exie1122/micro-quad-SLAM/drone photo.png

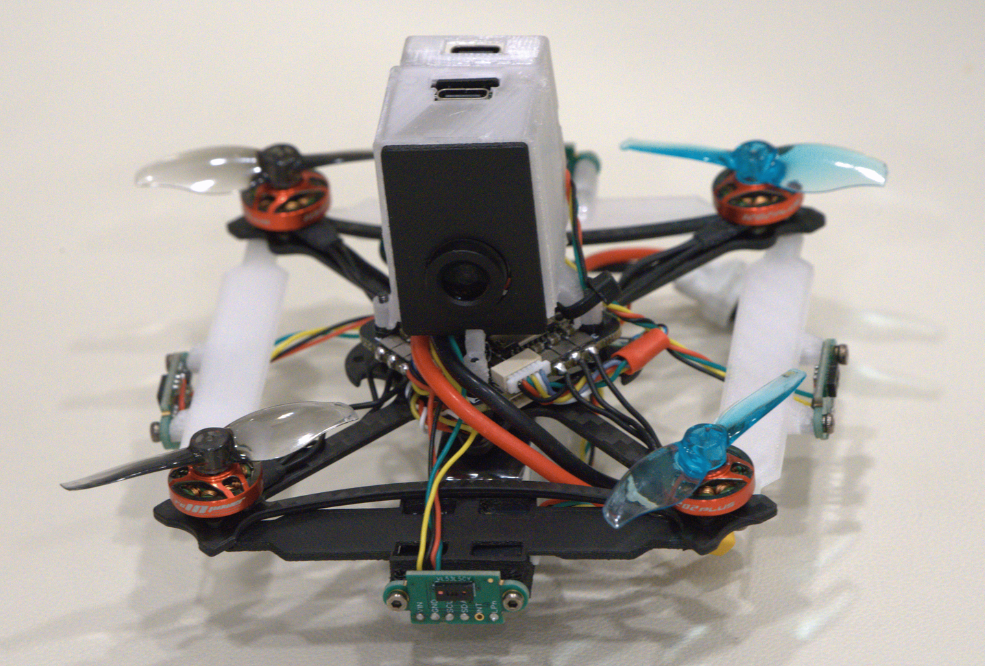
drone photo.png
