exie1122/micro-quad-SLAM/mapped_environment_2.png

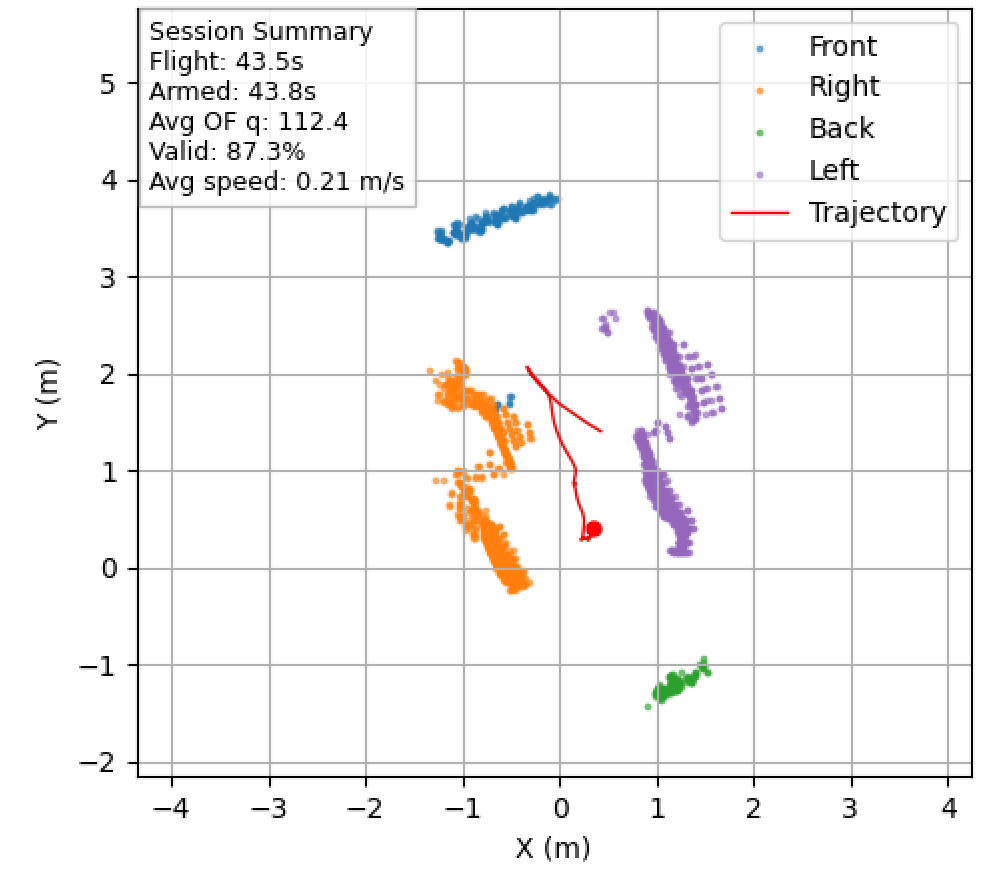
mapped_environment_2.png
