exie1122/micro-quad-SLAM/(commit log)

2026-01-23 Critical behaviour fixes. Previous version did not throttle up on TAKEOFF.
    [uav_local_nav.c]
2026-01-29 Add drift/flip fix for XY stability in hover control
    Implement drift and flip fix by ensuring XY stability before allowing position hold and exploration translation. Introduce new functions to check XY stability and modify hover hold behavior accordingly.
    [uav_local_nav.c]
2026-01-31 Change PRINT_HZ from 5 to 2 and adjust disarm timing
    Lowered PRINT_HZ, adjusted disarm timing and logic for safety. Most aspects of this commit were just a step back to my backup, since the new version flips quite often.
    [uav_local_nav.c]
2026-01-31 Adjust disarm command timing and conditions
    Reduce the minimum time between disarm commands from 50ms to 10ms. Remove altitude checks for forced disarm.
    Note: In ardupilot, also drastically decreased the roll and pitch P and I rates by around 60%, since there were audible and visible oscillations around the yaw axis.
    [uav_local_nav.c]
2026-03-10 Enhance hover phase management and safety checks
    Refactor hover control logic and improve stability checks. March 9th, 2026. 30 days until the science fair.
    [clean_uav_fc_tof_nav.c]
2026-03-12 Add manual UAV flight controller with logging
    This file implements a manual UAV flight controller for logging ToF data and MAVLink messages. It includes UART configuration, logging mechanisms, and various MAVLink message handlers for sensor data processing.
2026-03-15 Implement ToF scan log visualization in plot_scan.py
    Add a script to parse and visualize ToF scan logs with configurable parameters and filters.
    Includes:
    - Yaw estimation through Manhattan logic
    - 3D ray shifts for pitch/roll
    - Frame/accum. switches
    - Quality % filtering
2026-03-15 Adjust sensor position calculations with scaling
2026-03-19 Enhance plot_scan.py with new row mode and filter options
    Refactor plot_scan.py to improve functionality and add new features.
2026-03-25 Refine hover and takeoff logic with EKF integration
    Updated various constants and logic for hover and takeoff behavior, including adjustments to XY lock dwell time, velocity limits, and ceiling descent parameters. Added EKF status report handling and refined logging for altitude and EKF variance.
    Solved Problems:
    Auto land
    Yaw "twitch" without drift
    Overelaxed poshold conditions
    [clean_uav_fc_tof_nav.c]
2026-03-31 Refactor sendCmd and update PEER_MAC address
    Updated PEER_MAC address and modified sendCmd function to support sending commands multiple times with a delay. Adjusted button behavior for ARM and DISARM commands.
2026-03-31 Refactor sensor setup and enhance logging
    Refactor sensor initialization and update print statements for clarity.
2026-04-03 Add Flight Session Viewer GUI for UAV log files
    This script provides a GUI for parsing UAV log files, allowing users to browse arm sessions, copy data to clipboard, or export it.
2026-04-03 Refine hover and takeoff parameters for stability
    Adjust hover and takeoff parameters for improved stability and performance.
    [clean_uav_fc_tof_nav.c]
